Aleitao2/bambu-ams-rfid/esp32-ams-reader/secrets.example.h

// Copy this file to secrets.h and fill in your values.
#pragma once

const char* WIFI_SSID     = "your-2.4GHz-ssid";
const char* WIFI_PASSWORD = "your-wifi-password";

// Home Assistant base URL and a Long-Lived Access Token
// (HA → Profile → Security → Long-lived access tokens)
const char* HA_HOST  = "http://homeassistant.local:8123";
const char* HA_TOKEN = "your-long-lived-access-token";
