Aleitao2/bambu-ams-rfid/(commit log)

2026-10-28 Document AMS RFID board (FM17580) wiring, J74 pinout and tag registration flow
    Claude-Session: https://claude.ai/code/session_01T7Tk5y6ss3XY3Z3SwWneCr
2026-10-28 Add HA rest_commands, pyscript tag map, command_line sensor and setup guide
    IPs replaced with placeholders, Bambuddy API key moved to !secret.
    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
